vives-project-xp/PX4-Interactive-Sound-Art/Technische_documentatie/Bestelling/Materialen_info.md

# Materialen lijst

Prijzen kunnen variëren. Dit is voor 1 unit.

| Materiaal | Prijs (€) | Info | Voeding | URL | Datasheet |
| :---: | :---: | :---: | :---: | :---: | :---: |
| Raspberry Pi 4 | 51,49 | 4GB Ram | USB-C | [Kiwi](https://www.kiwi-electronics.com/nl/raspberry-pi-4-model-b-4gb-4268?country=BE&gad_source=1) | [Pi instellen](https://projects.raspberrypi.org/nl-NL/projects/raspberry-pi-setting-up) |
| Raspberry Pi 4 voeding | 7,49 | USB-C | / | [Kiwi](https://www.kiwi-electronics.com/nl/raspberry-pi-4-usb-c-voeding-zwart-eu-4270) | [Datasheet](https://datasheets.raspberrypi.com/power-supply/15w-usb-c-power-supply-product-brief.pdf) |
| Levelshifter | 3,69 | 3,3 - 5,0V | 3,3 & 5,0V | [Kiwi](https://www.kiwi-electronics.com/nl/sparkfun-logic-level-converter-bi-directional-3154?country=BE&gad_source=1) | [Datasheet](https://cdn.sparkfun.com/datasheets/BreakoutBoards/BSS138.pdf) |
| Voeding 5/12V RT-65B | 21,32 | 64 W | / | [Conrad](https://www.conrad.be/nl/p/mw-mean-well-rt-65b-schakelnetvoedingsmodule-64-w-1293137.html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) | [Datasheet](https://asset.conrad.com/media10/add/160267/c1/-/en/001293137DS01/datablad-1293137-mw-mean-well-rt-65b-schakelnetvoedingsmodule-64-w.pdf) |
| Leds SK6812 | 32,42 | Individual addressable | 5V | [BTF-Lighting](https://www.btf-lighting.com/products/1-sk6812-rgbw-4-in-1-pixels-individual-addressable-led-strip-dc5v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) | [Datasheet](https://cdn-shop.adafruit.com/product-files/1138/SK6812+LED+datasheet+.pdf) |
| Ultrasone sensor | 5,19 | Meethoek: 15°, Bereik: 2 - 4cm | 5V | [Kiwi](https://www.kiwi-electronics.com/nl/ultrasoon-sensor-hc-sr04-2592?country=BE&gad_source=1) | [Datasheet](https://cdn.sparkfun.com/datasheets/Sensors/Proximity/HCSR04.pdf) |
| Speakers | 18,17 | 15 W 4 Ω | / | [Conrad](https://www.conrad.nl/nl/p/visaton-fr-9-15-4-ohm-5-9-inch-15-cm-breedband-luidspreker-15-w-4-ovaal-305270.html) | [Datasheet](https://asset.conrad.com/media10/add/160267/c1/-/de/000305270DS01/datablad-305270-visaton-fr-915-4-ohm-59-inch-15-cm-breedband-luidspreker-15-w-4-ovaal.pdf) |
| Versterker | 3,26 | mono 18W | 6 - 12V | [Hobby Electronica](https://www.hobbyelectronica.nl/product/audio-versterker-module-tda2030a/) | [Datasheet](https://www.openimpulse.com/blog/wp-content/uploads/wpsc/downloadables/TDA2030A-HI-FI-Audio-Amplifier-Chip-Datasheet.pdf) |
| Jackplug |  1,93 | 3,5mm Stereo Jack Plug | / | [Farnell](https://be.farnell.com/pro-signal/jr8013-7m/lead-3-5mm-s-jack-jack-7m/dp/4258502) | [Datasheet](https://www.farnell.com/datasheets/15639.pdf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) |
| USB-geluidskaarten | 8,67 | Externe geluidskaart | / | [AlleKabels](https://www.allekabels.be/delock/6335/4398057/delock-externe-usb-soundkarte-mit-usb-a-stecker-auf-2-x-35-mm-klinkenbuch.html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) | [Datasheet](https://www.delock.com/produkt/66633/pdf.html?sprache=en) |
| Verdeelstekker | 7,43 | 4x met schakelaar, 1,5m | / | [Hubo](https://www.hubo.be/nl/p/profile-stekkerdoos-4x-met-schakelaar-kabel-1-5m-wit/10063/) | / |
| MDF Platen (2 unit's) | 20,66 | 244x122cm 12mm | / | [Hubo](https://www.hubo.be/nl/p/mdf-plaat-244x122-cm-12mm/81042/) | / |
| Schroeven | 3,05 | 4x12mm 20 stuks | / | [Brico](https://www.brico.be/nl/ijzerwaren/technische-bevestigingsmaterialen/schroeven/universele-schroeven/spax-universele-schroef-ronde-kop-4x12mm-20-stuks/0877200) | / |
| Scharnieren | 11,15 | diameter 26mm | / | [Brico](https://www.brico.be/nl/ijzerwaren/meubelbeslag/meubelscharnieren/opbouwscharnieren/vynex-onzichtbare-scharnier-dia-26mm-94-voor-inliggende-deur-vernikkeld-staal/547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) | / |
| Hoekankers | 5,28 | 30x30x14mm 20 stuks | / | [Hubo](https://www.hubo.be/nl/p/fg-wood-connectors-hoekanker-30x30x14-mm-20-stuks/86273/) | / |
| Acryl buis | 42,98 | 1000x100x3mm | / | [Kunststofshop](https://www.kunststofshop.nl/acrylaat-plexiglas/acrylaat-buizen/melkwit-opaal/acrylaat-buis-opaal-1000x100x3mm-1000x100x3mm/a-3806-20000036) | / |
Totaal prijs (excl. btw) : 243,14 €
