vives-project-xp/PX4-Interactive-Sound-Art/Technische_documentatie/README.md

# Technische documentatie

Deze map bevat alle technische informatie die nodig is om het PX4-Interactive-Sound-Art project op te bouwen, begrijpen en presenteren. De documentatie ondersteunt zowel de hardware- als softwarecomponenten van de installatie.

## Inhoudstafel

- **[Bestelling](./Bestelling/Materialen_info.md)**  
  Bevat een overzicht van alle benodigde materialen en componenten, inclusief bestellijst en leveranciersinformatie.

- **[Foto's](./Foto's/)**  
  Hier zijn alle foto's te vinden die in deze repository gebruikt worden.

- **[Introductieposter](./Introductieposter/soundArt.pdf)**  
  De officiële projectposter met een beknopte uitleg van het concept, de werking en de doelstelling van de installatie.

- **[Schema's](./Schema's/)**  
  Bevat verschillende schema’s zoals het elektrisch schema, het aansluitschema om de Raspberry Pi aan te sluiten met de speaker via de versterker, het software schema en het blokschema die de technische werking van het systeem visualiseren.

## Gebruik

Raadpleeg deze map bij het bouwen, testen of presenteren van het project. De inhoud biedt ondersteuning bij zowel praktische uitvoering als theoretische onderbouwing.

⬅️ [Terug naar overzicht](../README.md#specificaties)
