vives-project-xp/PX4-Interactive-Sound-Art/Geluidsbestanden/README.md

# Geluidsbestanden

Deze map bevat alle audiobestanden die gebruikt worden in het PX4-Interactive-Sound-Art project. De geluiden worden dynamisch afgespeeld op basis van handbewegingen die door de sensor worden gedetecteerd.

## Bestandsformaat

Alle audiobestanden zijn opgeslagen in `.mp3`-formaat en alle geluiden vereisen acht verschillende niveau's.

## Gebruik

Deze bestanden worden automatisch geladen en afgespeeld door de code op de Raspberry Pi. Het is belangrijk dat de bestandsnamen en structuur behouden blijven voor een correcte werking van het systeem.

---

Indien je nieuwe geluiden wil toevoegen, klik [hier](../Code_Raspberry_Pi/README.md#3-hoe-extra-geluiden-toe-te-voegen) voor extra uitleg. Zorg ervoor dat ze correct zijn geformatteerd en logisch worden geplaatst binnen de bestaande structuur.

⬅️ [Terug naar overzicht](../README.md#specificaties)
