vives-project-xp/PX4-Interactive-Sound-Art/website/backend/README.md

# Manuele setup

1) **Download de GitHub repository**
```bash
git clone https://github.com/vives-project-xp/PX4-Interactive-Sound-Art.git
```

2) **Terminal in backend**
```bash
cd website/backend
```

# Vanaf hier in docker

3)  **Zorg ervoor dat het volgende geïnstalleerd is:**
- Node.js 
- npm 

4) **Installeer de benodigde pakketten**
```bash
npm install
```

5) **Start de server**
```bash
npm start
```

⬅️ [Terug naar overzicht](../README.md#technische-informatie)
