vives-project-xp/PX4-Interactive-Sound-Art/website/frontend/README.md

# Interactive Sound Art Controller - Frontend

Welkom bij de frontend van de Interactive Sound Art Controller. Deze handleiding helpt je om het project snel op te starten en lokaal uit te voeren.

## Vereisten
- [Node.js](https://nodejs.org/) (versie 12 of hoger aanbevolen)
- npm (wordt standaard meegeleverd met Node.js)

## Installatiestappen

1. **Clone de repository:**
   ```bash
   git clone https://github.com/vives-project-xp/PX4-Interactive-Sound-Art.git
   cd vives-project-xp PX4-Interactive-Sound-Art
   ```
2. **Installeer de packages:**
    ```bash
    npm install
    ```
3. **Start the Frontend:**
    ```bash
    npm run dev
    ```

    ⬅️ [Terug naar overzicht](../README.md#technische-informatie)
