vives-project-xp/PX4-Interactive-Sound-Art/Technische_documentatie/Introductieposter/soundArt.pdf

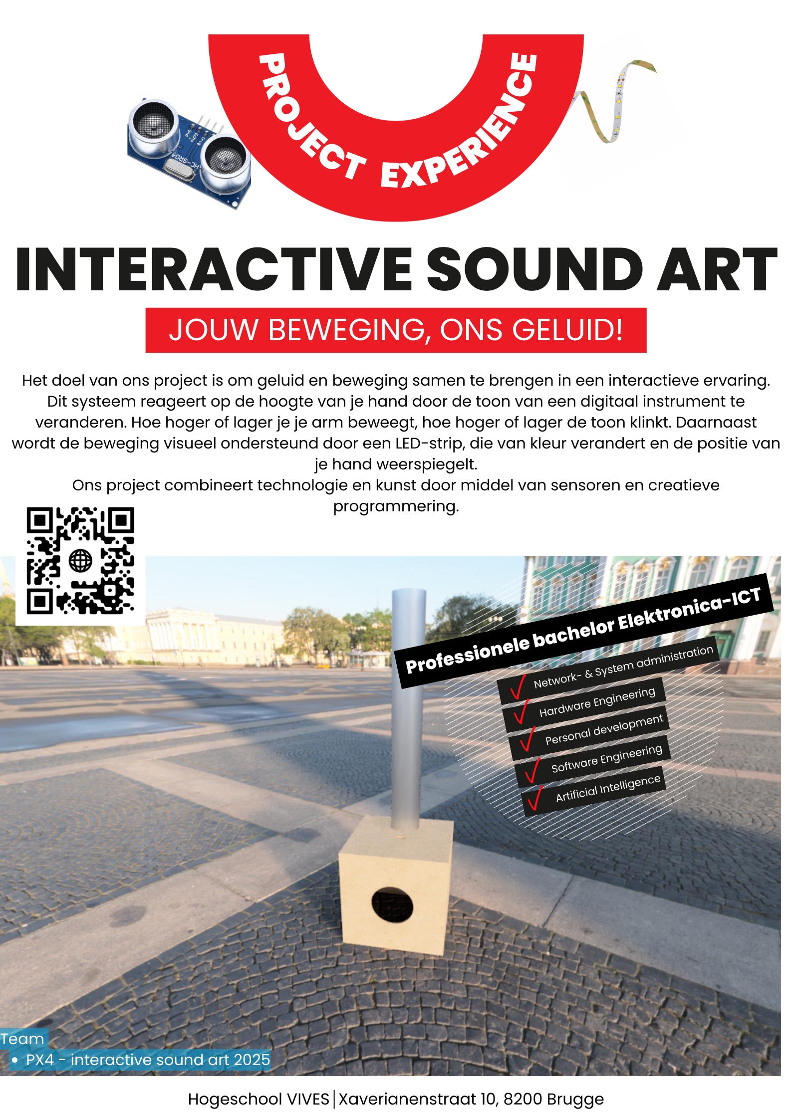
[picture p7: page 1]
