vives-project-xp/PX4-Interactive-Sound-Art/Technische_documentatie/Foto's/scope_0.png

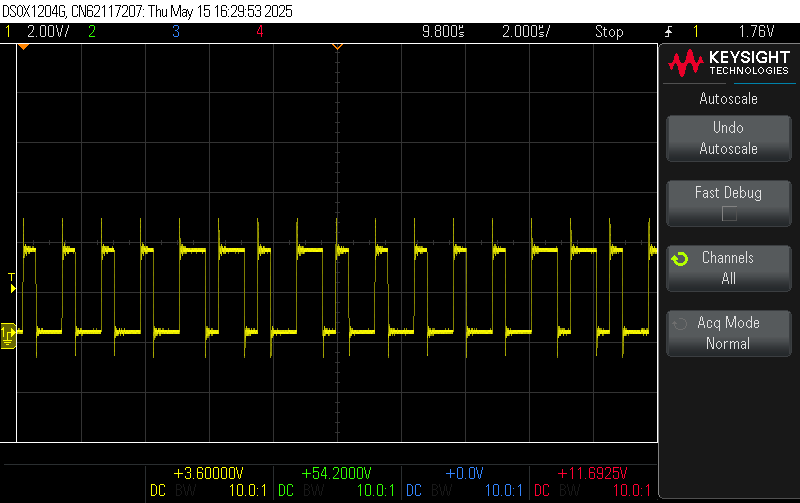
Technische_documentatie/Foto's/scope_0.png
