vives-project-xp/PX4-Interactive-Sound-Art/Technische_documentatie/Schema's/architectuurV3.jpg

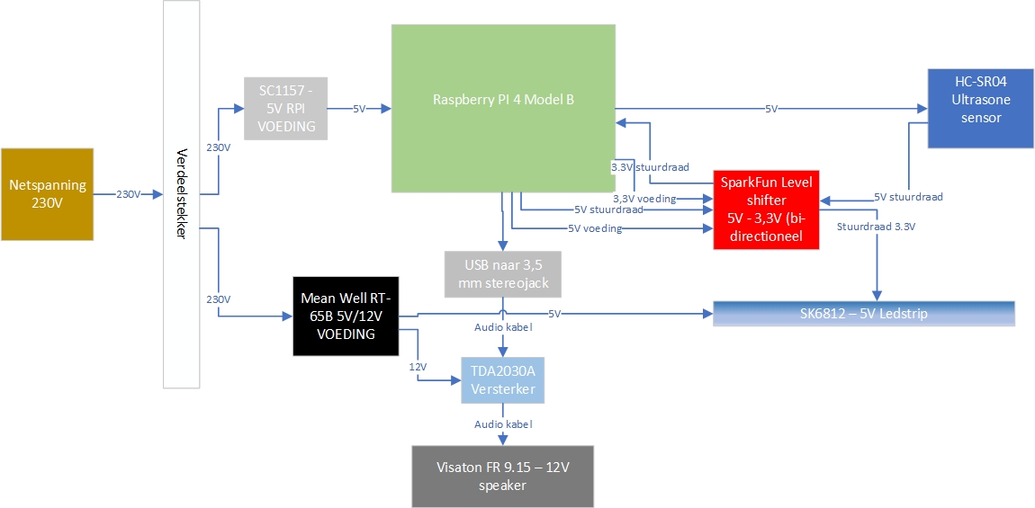
Technische_documentatie/Schema's/architectuurV3.jpg
