vives-project-xp/PX4-Interactive-Sound-Art/Technische_documentatie/Schema's/Elektrisch schema.png

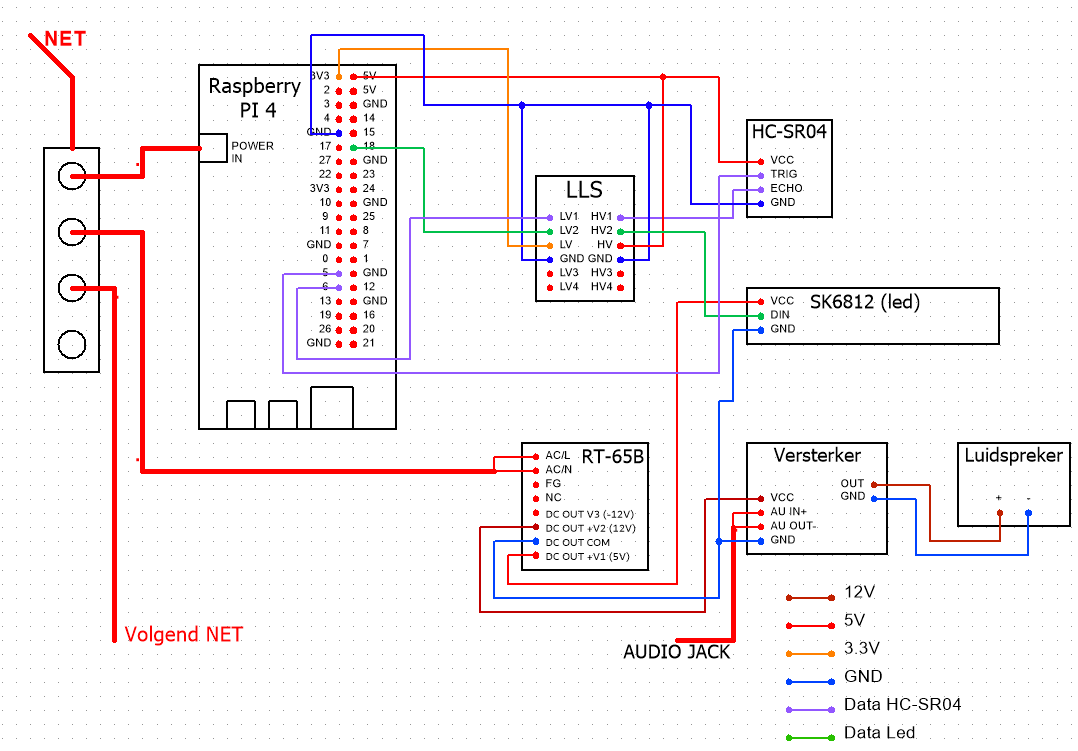
Technische_documentatie/Schema's/Elektrisch schema.png
