vives-project-xp/PX4-Interactive-Sound-Art/Technische_documentatie/Schema's/Elektrisch Scheme V2.pdf

0

1

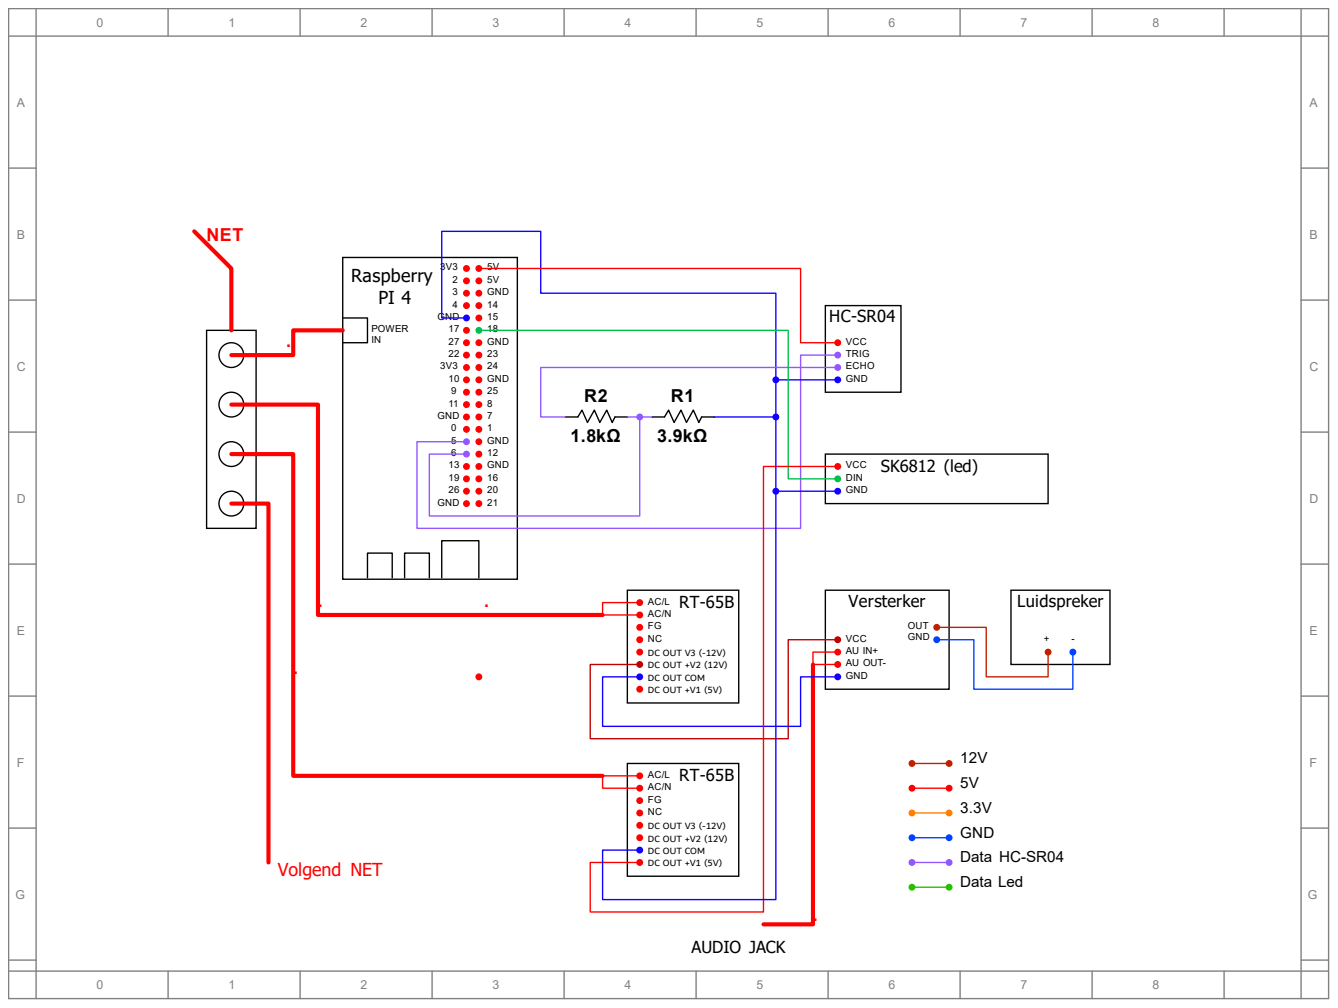
[picture p15: page 1]
Raspberry PI 4; 5V 2 5V GND; GND; VCC TRIG ECHO GND; VCC; DIN; Luidspreker; VCC AU IN+ AU OUT-; OUT; POWER IN .; AUDIO JACK; SK6812 (led); Versterker; NET; Volgend NET; 5V 3.3V GND Data HC-SR04 Data Led

DC OUT V3 (-12V)
DC OUT +V2 (12V)
DC OUT COM
DC OUT +V1 (5V)
