vives-project-xp/PX4-Interactive-Sound-Art/Technische_documentatie/Schema's/SoftwareArchPX4.pdf

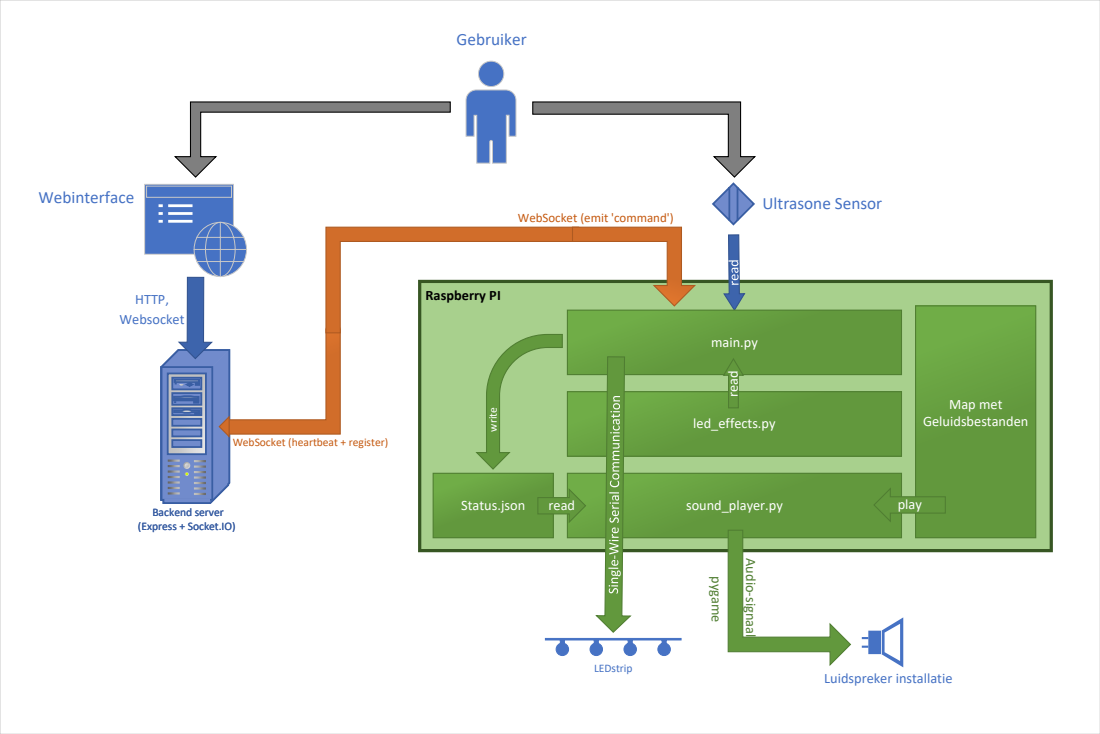
[picture p16: page 1]
Ultrasone Sensor; Raspberry PI; main.py; Gebruiker; led_effects.py; sound_player.py; Webinterface; Luidspreker installatie; LEDstrip; Map met Geluidsbestanden; Status.json; read; play; write; Audio-signaal; pygame; HTTP, Websocket

WebSocket (emit 'command')

WebSocket (heartbeat + register)

Backend server
(Express + Socket.IO)
