vives-project-xp/PX4-Interactive-Sound-Art/(commit log)

2025-02-06 afstands sensor
2025-02-10 Expand documentation for standalone device
2025-02-13 ESP32 onderzoek
2025-02-17 ESP32 code
2025-02-17 Raspberry Test Codes added
2025-02-27 Update materials documentation
2025-03-13 added color effect for the leds on the interface
2025-03-16 Update WERKENDE_CODES.md
    ffkes probeern
2025-03-16 restore LED_effecten.md
2025-03-20 remove HTTP endpoint for updating LED settings
2025-03-27 change order buttons frontend
2025-03-27 update led effect
2025-03-27 removed confirmed button (not needed since we work with websockets)
2025-03-27 change for leds if hightstick
2025-03-27 fire effect bug fix
    [led_effects.py]
2025-03-27 stop led effect blocked if no hand
2025-04-03 refactor(socket): enhance WebSocket connection handling
2025-04-03 add socket connection event listener
2025-04-24 refactor(frontend): optimize main.js by removing redundancy and adding WebSocket
    Remove duplicate app mounting line and add WebSocket connection for real-time communication. The socket instance is provided globally to ensure accessibility across the application.
2025-04-24 feat(backend): add functionality to manipulate MP3 pitch and create variations
2025-05-08 vastlopen led effecten fixed
    [main.py]
2025-05-15 idle mode bug fix
    [led_effects.py, main.py]
